drewballz1/Home-Assistant-Display-and-Satellite---Raspberry-Pi/README.md

# Raspberry Pi Touch Display 2 — Voice Satellite Stand

A desk stand for the **Raspberry Pi Touch Display 2 (7", landscape)** that houses a **Raspberry Pi 5**, a **Seeed ReSpeaker Lite** (2-mic array) and a **3" speaker** in a sealed box. It turns the display into an always-on Home Assistant panel (e.g. a doorbell camera feed) and a voice-assistant satellite (Linux Voice Assistant with a custom wake word).

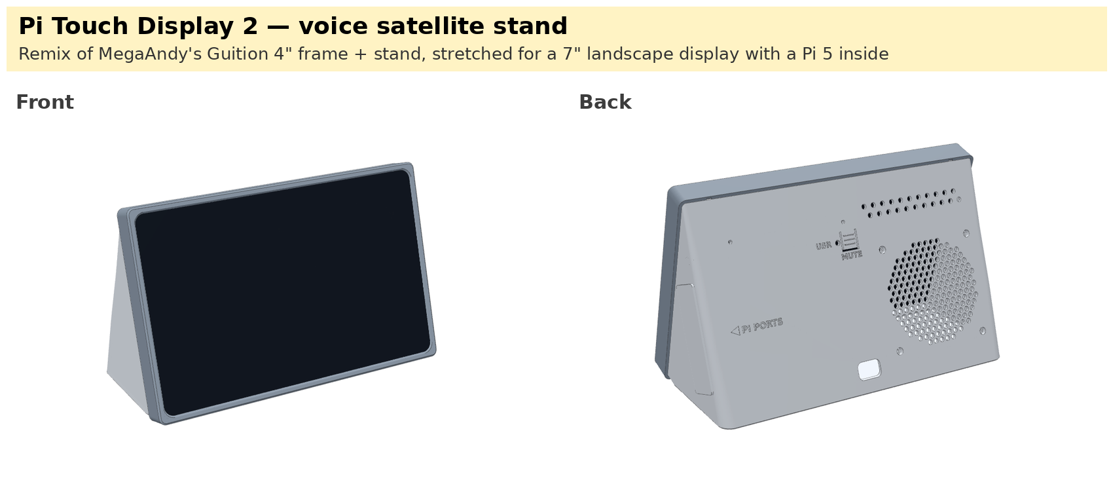
[picture p1: images/overview.png]
Overview


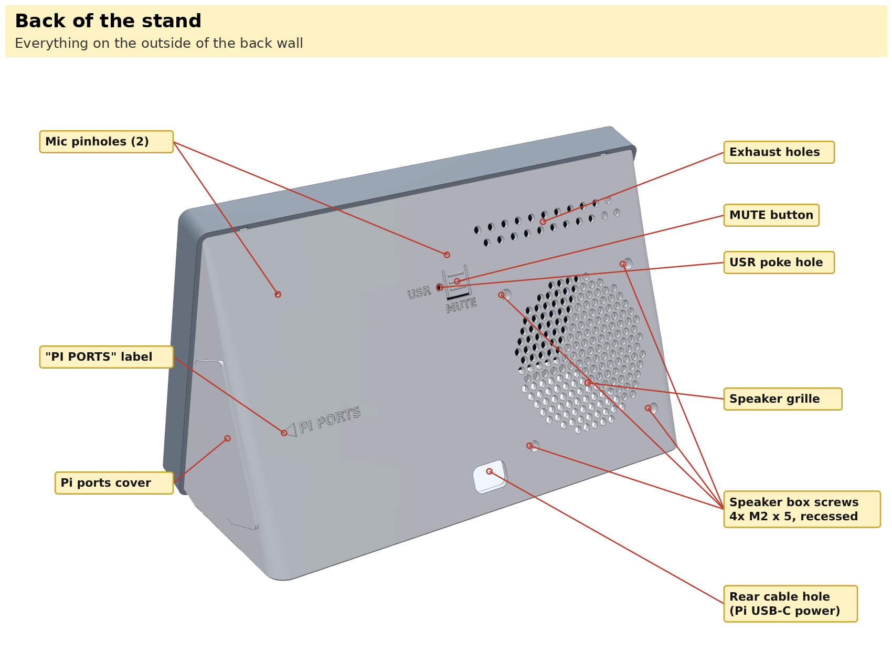
[picture p2: images/back-features.png]
Back of the stand


> **Remix notice.** This is a remix of **["Guition 4 inch Screen Frame and Stand (ESP32-S3-4848S040)" by MegaAndy](https://www.printables.com/model/1881011-guition-4-inch-screen-frame-and-stand-esp32-s3-4848s040)** on Printables. The frame band, wedge stand shape, snap tabs/grooves, rear cable hole, weighted base and foot recess all come from that design. The original STLs were stretched (not scaled) so every tested feature keeps its original size. This remix is shared under the same licence: **attribution required, non-commercial use only**.

## Print set (`stl/`)

| File | Print orientation | Notes |
|---|---|---|
| `stand.stl` | As exported: open front face down (same as the original) | ~190 × 123 mm footprint, 82 mm tall. Use a brim. No supports. |
| `frame.stl` | As exported: lip down | 194 × 125 × 16 mm. No supports. |
| `speaker-box.stl` | As exported: rim down | 80 × 80 × 60 mm. No supports (the inside must not have any). |
| `pi-ports-cover.stl` | As exported: plate down | 64 × 42 × 3.6 mm. No supports. |

Materials: **matte black ASA** for the stand, speaker box and cover; the frame in **Spectrum PET-G MATT Olive Green (RAL 6003)**, plain matte print (no fuzzy skin). 0.4 mm nozzle, 0.2 mm layers, 4 walls, 25 % infill, **no supports**. Bed of at least 200 × 130 mm (both plates below are laid out for 256 × 256). All parts were slice-checked (PrusaSlicer 2.7): no stability warnings, about 246 g in total.

**Sending it to a print shop (Bambu):** `print/` holds exactly what the printer gets and nothing else:
`TD2-plate-A-black-ASA-stand-box-cover.3mf` and `TD2-plate-B-olive-frame.3mf` (parts placed in print orientation), a plain-language note `TD2-note-for-Jayed.txt` and one picture `TD2-what-to-check.png`.

**Screw pilots and mic holes are printed undersize on purpose: drill them on site.** See [`docs/on-site-fixes.md`](docs/on-site-fixes.md) (1/16" and 3/32" bits). Design decisions and their reasons: [`docs/design-notes.md`](docs/design-notes.md).

## Hardware

| Part | Notes |
|---|---|
| Raspberry Pi Touch Display 2, 7" | 189.32 × 120.24 mm glass, 6.45 mm edge |
| Raspberry Pi 5 (2 GB is plenty) + Active Cooler (SC1148) | |
| 27 W USB-C power supply + USB-C cable with a **right-angle** Pi end | |
| Raspberry Pi 5 display cable, 22-way to 15-way, **300 mm** | the cable in the display box is meant for back-mounting the Pi |
| Seeed ReSpeaker Lite **USB** 2-Mic Array (no XIAO) | board revision v1.1 |
| Adafruit 3" speaker, 4 Ω 3 W | |
| JST-PH 2.0 mm 2-pin lead | speaker → ReSpeaker |
| Short USB-A → USB-C **data** cable, **right-angle on both ends** | Pi → ReSpeaker; the Pi's USB ports have 21 mm to the side cover |
| 1/16" and 3/32" drill bits, hobby knife | on-site fixes: pilots and mic holes are printed undersize |
| 10 × M2 × 5 pan-head self-tapping | the only screw in the build: 4 for the Pi, 2 for the ReSpeaker, 4 from the back into the speaker box (heads sit in recessed holes) |
| Foam tape: 2 mm (spacer ring), 1 mm (mic squares), 3 mm ring (speaker front), thin gasket (box rim) | |
| Optional: 1" × ½" steel flat bar, 3¾" long (~240 g) | glued into the weight tray on the floor |
| Optional: rubber feet, hot glue | |

## Features

- **Original look**: thin snap-on frame band and wedge stand, scaled up for a 7" landscape screen. Five snap tabs per long edge (three added, copied exactly from the original geometry).
- **Display clamp**: a spacer ring on the stand takes the 6.45 mm glass; 2 mm foam tape on the ring absorbs the ±0.5 mm tolerance. Frame corners match the glass's 8 mm radius.
- **Pi 5** on four printed standoffs on the back wall; USB-C power port sits right above the rear cable hole. Fit the microSD card before mounting.
- **Pi ports access**: clip-on cover on the right side (as you face the screen) over the USB / Ethernet end; lift it off with a fingernail at the notch under its lower front corner. See `images/pi-ports-cover.png`.
- **ReSpeaker Lite** on two M2 standoffs, mics sealed to two back-wall pinholes with small foam squares on raised pads.
- **MUTE** is a press-in flexure button printed into the back wall (with grip ridges); **USR** is a poke hole. Both engraved.
- **3" speaker** in its own sealed box (~160 cm³), clamped by four screws from the back; round-hole grille in the back wall.
- **Ventilation**: intake slots under the Pi, round exhaust holes along the top of the back wall.
- **Weight tray** on the floor for a steel bar (glued in), fitted before the display goes on.

## Assembly order

0. Do the on-site fixes (`docs/on-site-fixes.md`): drill the pilots and mic holes, clear the MUTE slot, test-fit the frame and cover.
1. Flash the microSD and insert it into the Pi.
2. Speaker: solder the JST lead (leave a little slack inside the box, tack it with hot glue), 3 mm foam ring on the wall around the grille, speaker face-down on its pads, gasket on the box rim, box over the speaker, four M2 × 5 screws from the back (into the recessed holes). Seal the wire hole with hot glue.
3. ReSpeaker: foam squares on the two mic pads, each with a clean **Ø2 mm hole** lined up with its pinhole (a 2 mm hollow punch, or a 5/64" bit twisted by hand; don't just pierce it, a pin-prick muffles the mic). The seal must be airtight all round. Board on its standoffs (mics to the wall), two M2 × 5 screws.
4. Pi: four M2 × 5 screws. Connect the ReSpeaker (USB), speaker (JST-PH), display ribbon (300 mm, fold the slack flat) and the display's GPIO power lead.
5. Weight bar into its tray (construction adhesive or hot glue).
6. 2 mm foam tape on the spacer ring, display on the ring, frame snapped on (feed cables first).
7. Side cover on; rubber feet on the base.

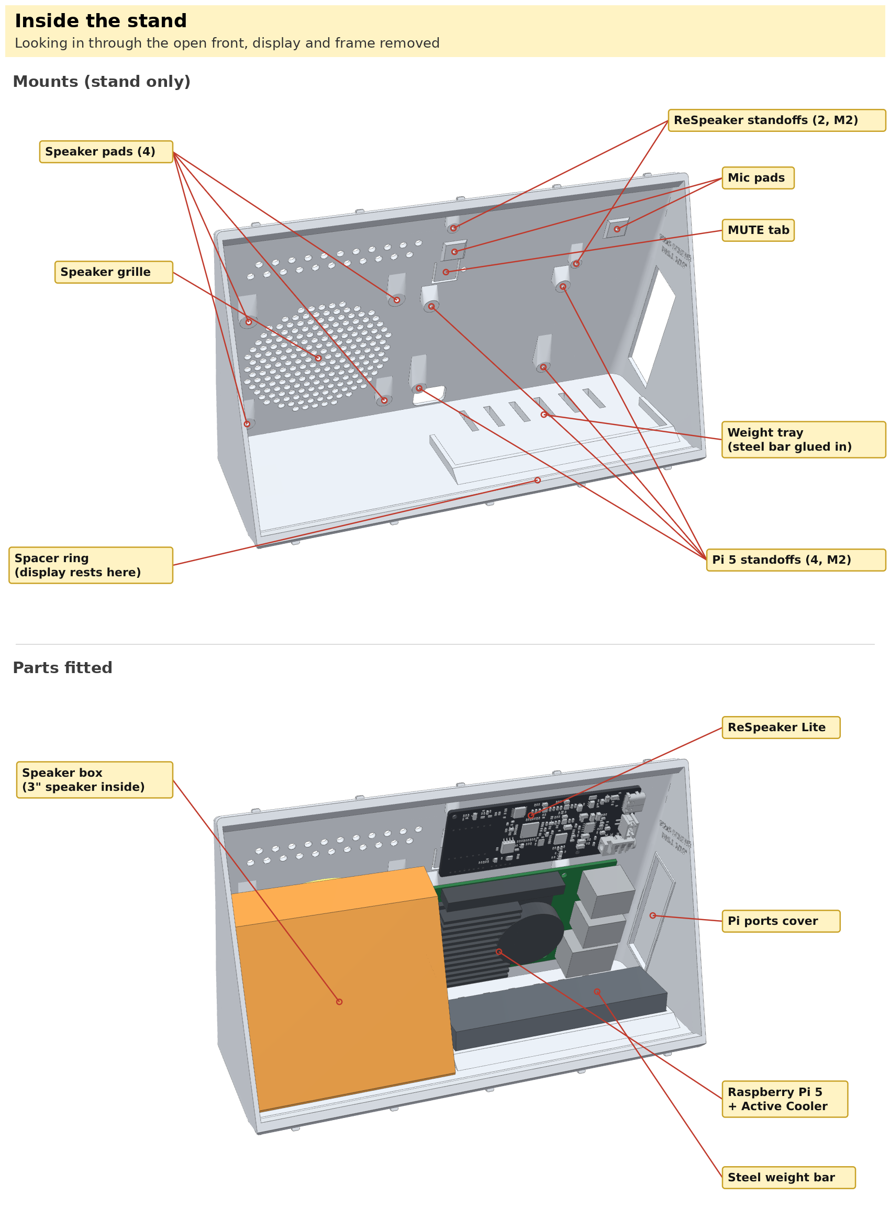
[picture p3: images/inside-mounts.png]
Inside the stand

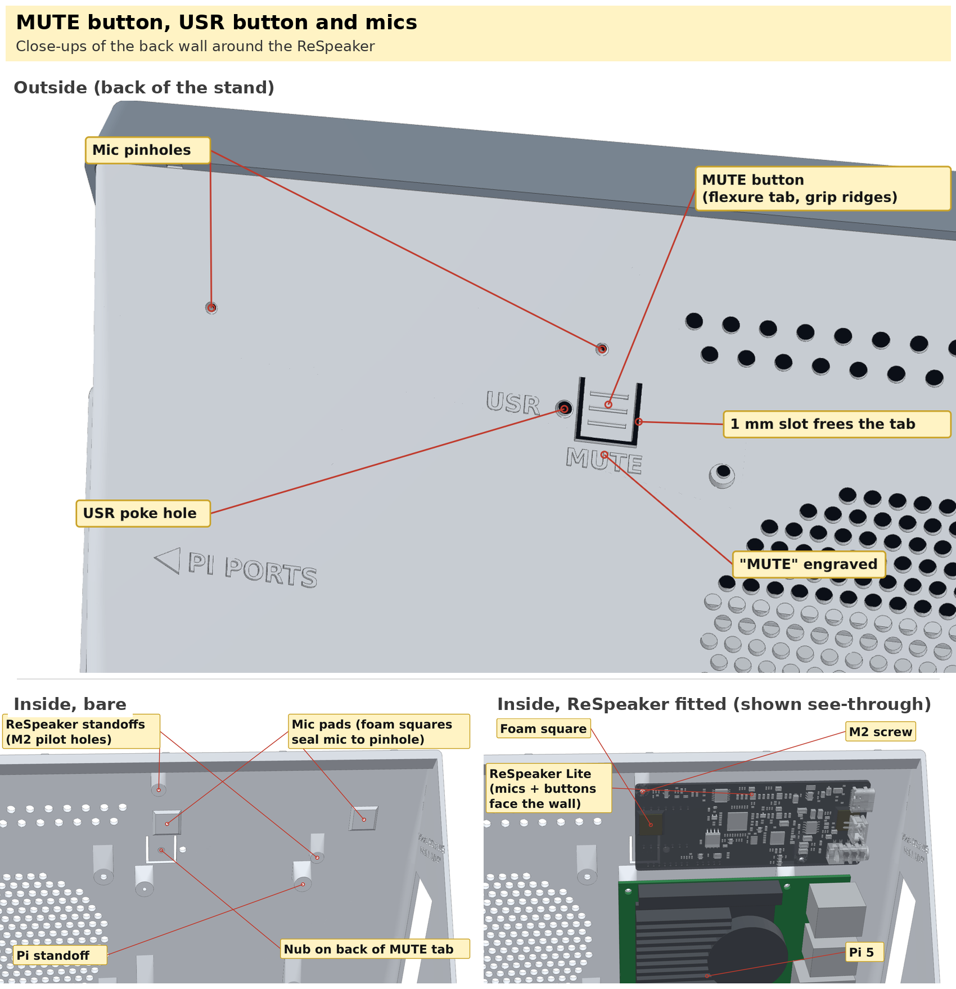
[picture p4: images/mute-button.png]
MUTE button, USR button and mics

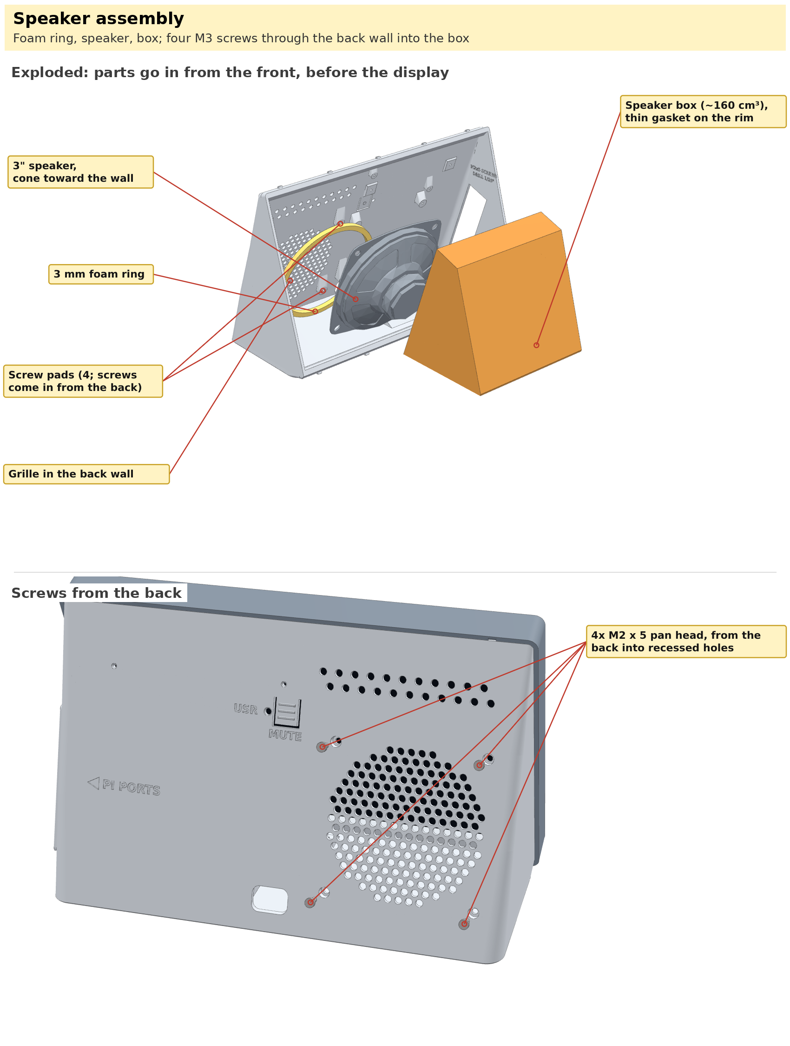
[picture p5: images/speaker-assembly.png]
Speaker assembly

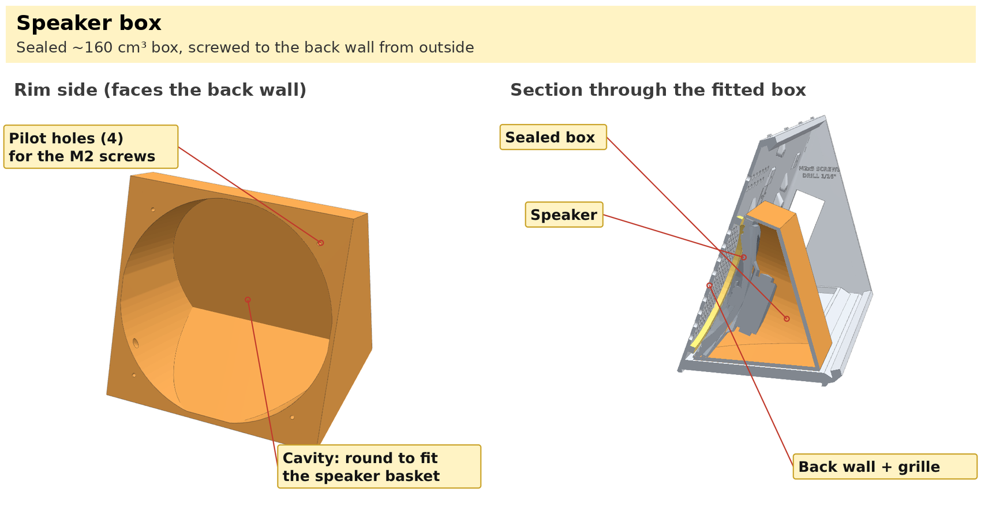
[picture p6: images/speaker-box-sections.png]
Speaker box

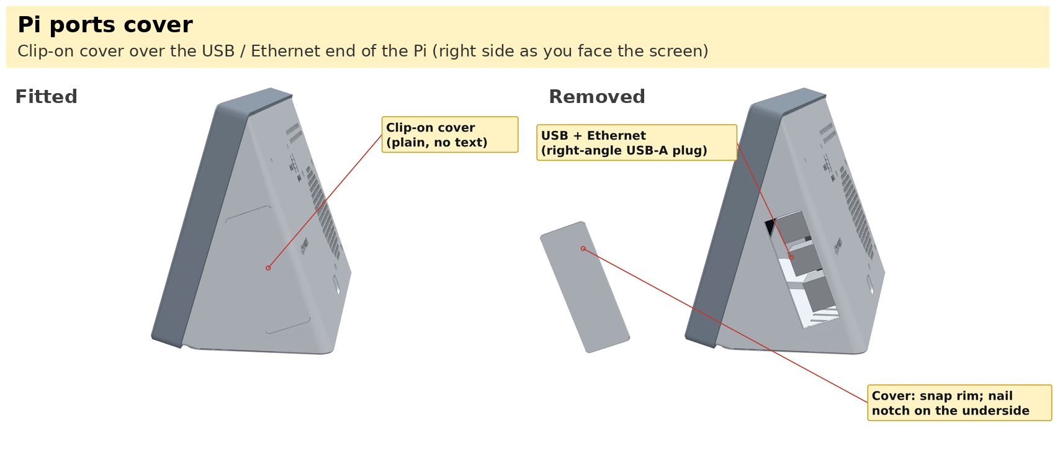
[picture p7: images/pi-ports-cover.png]
Pi ports cover


## Check before printing

These were designed from published CAD / drawings and need a quick check against the real parts:

1. **Speaker tabs**: geometry is from Adafruit's CAD for the 8 Ω 1 W 3" speaker (same frame size as the 4 Ω 3 W). Confirm the four corner slots line up with a 60 mm square.
2. **ReSpeaker**: confirm the board is v1.1 and that the button marked MUTE is the one nearer the left end (the end without connectors). If not, swap `btn_label` in `source/td2-stand-additions.scad`.
3. **Glass edge thickness**: if it measures 6.45 mm, 1 mm foam on the ring is enough; otherwise use 2 mm.

## Software (brief)

- Home Assistant dashboard / camera feed in a full-screen browser (kiosk).
- **Linux Voice Assistant** (Open Home Foundation) as the Assist satellite; custom microWakeWord / openWakeWord models load from its wake-word folder.
- The Pi 5 has no hardware H.264 decoder — use a 720p sub-stream for the camera feed.

## Source (`source/`)

OpenSCAD + Python (trimesh / manifold3d) build scripts. `stretch.py` performs the feature-preserving stretch of the original STLs (download them from the original Printables page — they are not redistributed here). `td2-stand-additions.scad` holds the added features and their parameters; `compose.py` assembles the stand; `spkbox2.py`, `door.py`, `frame_corners.py` build the other parts; `check.py` / `check2.py` run the clearance checks. `fix_planar.py` repairs triangles the stretch folds over on flat faces (run on the stretched base and on the composed stand); `folds.py` and `thin.py` check every part for fold-overs and sub-0.2 mm skins. `render/` holds the three.js renderer used for the images in `images/`.

Dimensions were taken from: the Raspberry Pi Touch Display 2 product brief, Seeed's ReSpeaker Lite v1.1 STEP model, and Adafruit's CAD parts library. Those source files are not included.

## Licence

**CC BY-NC 4.0** — see `LICENSE`. Credit: original design by **MegaAndy**, ["Guition 4 inch Screen Frame and Stand (ESP32-S3-4848S040)"](https://www.printables.com/model/1881011-guition-4-inch-screen-frame-and-stand-esp32-s3-4848s040) on Printables.
