drewballz1/Home-Assistant-Display-and-Satellite---Raspberry-Pi/print/TD2-plate-B-olive-frame.3mf

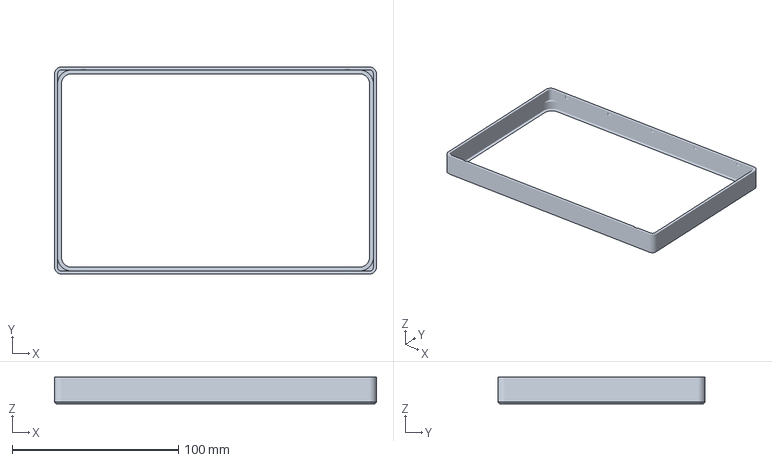
[picture p8: CAD file, 2026-11-02]
print/TD2-plate-B-olive-frame.3mf
193.6 x 124.5 x 16.0 mm
