drewballz1/Home-Assistant-Display-and-Satellite---Raspberry-Pi/stl/stand.stl

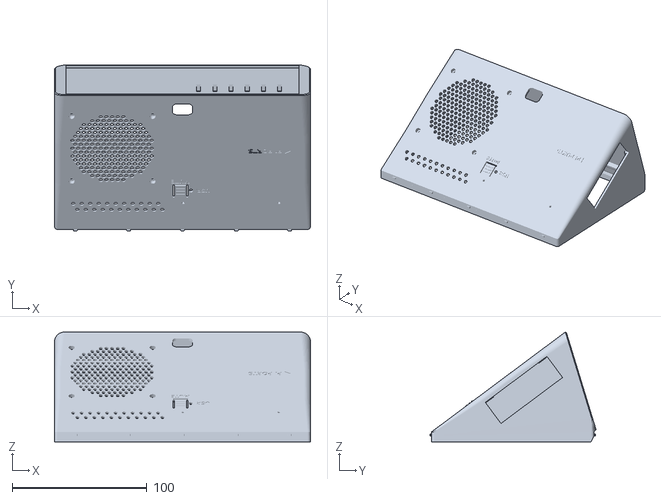
[picture p9: CAD file, 2026-11-02]
stl/stand.stl
189.7 x 123.1 x 81.5
