drewballz1/Home-Assistant-Display-and-Satellite---Raspberry-Pi/print/TD2-plate-A-black-ASA-stand-box-cover.3mf

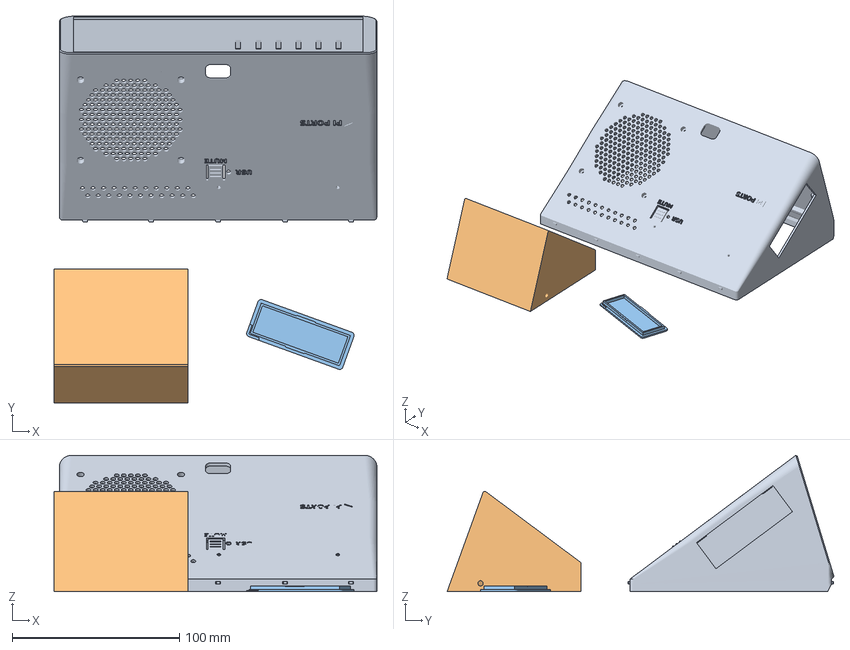
[picture p10: CAD file, 2026-11-02]
print/TD2-plate-A-black-ASA-stand-box-cover.3mf
192.9 x 231.0 x 81.5 mm
stand
speaker-box
pi-ports-cover
