drewballz1/Home-Assistant-Display-and-Satellite---Raspberry-Pi/stl/speaker-box.stl

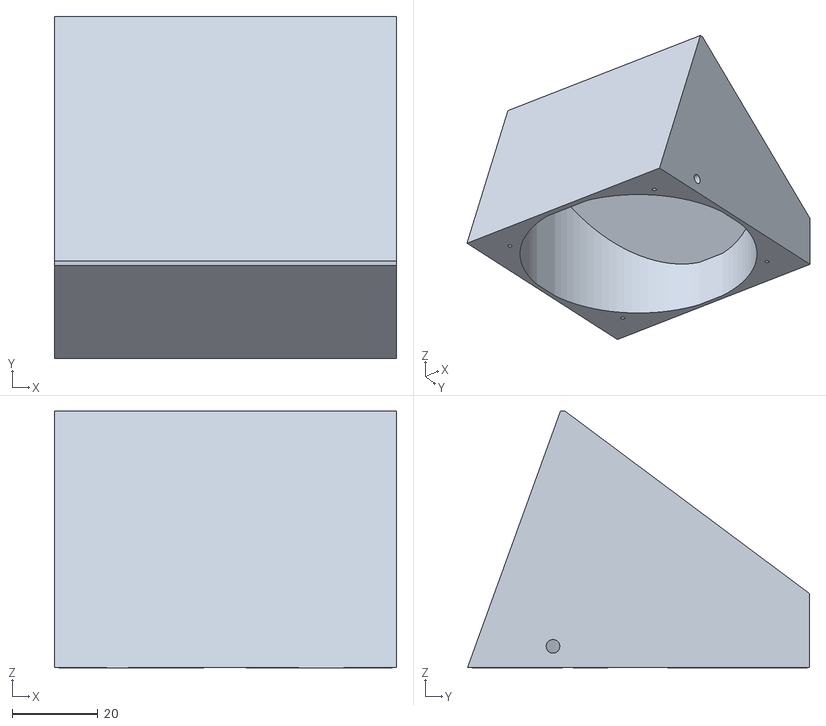
[picture p11: CAD file, 2026-11-02]
stl/speaker-box.stl
80.0 x 80.0 x 60.0
