drewballz1/Home-Assistant-Display-and-Satellite---Raspberry-Pi/stl/pi-ports-cover.stl

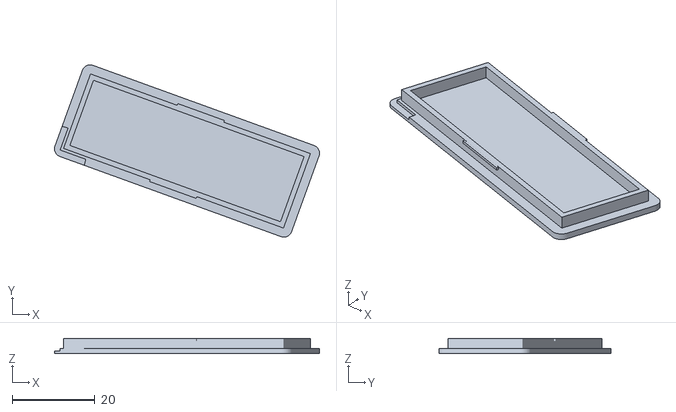
[picture p12: CAD file, 2026-10-27]
stl/pi-ports-cover.stl
64.2 x 41.7 x 3.56
