drewballz1/Home-Assistant-Display-and-Satellite---Raspberry-Pi/source/M.scad

M_USE = [[1.000000,0.000000,0.000000,0.000000],[0.000000,-0.289177,0.957276,45.650156],[0.000000,-0.957276,-0.289177,133.793919],[0.000000,0.000000,0.000000,1.000000]];
