drewballz1/Home-Assistant-Display-and-Satellite---Raspberry-Pi/(list of files, cad)

Other CAD files:
stl/frame.stl
