drewballz1/Home-Assistant-Display-and-Satellite---Raspberry-Pi/print/TD2-note-for-Jayed.txt

Hi Jayed, here are the Bambu Studio files for the TD2 display stand. 2 files, 4 parts, already placed on the plate the right way up. Please print them as-is.

FILE 1: TD2-plate-A-black-ASA-stand-box-cover.3mf
  1 x stand, 1 x speaker box, 1 x cover
  Material: matte black ASA, 0.20 mm layers (0.20mm Standard)

FILE 2: TD2-plate-B-olive-frame.3mf
  1 x frame
  Material: Spectrum PET-G MATT Olive Green (RAL 6003), or the closest matte olive you have (check with me first). 0.20 mm layers.

1. Open the .3mf. If it says "not from Bambu Lab, load geometry only", that's normal. Click OK.
   If it also says it repaired a few mesh errors, that's fine too (tiny flat slivers, no effect on the print).
2. Pick your printer, the material above, 0.20mm Standard.
3. Change only these (both files):
   - Strength > Walls > Wall loops = 4
   - Strength > Sparse infill > Sparse infill density = 25%
   - Support > Enable support = OFF (nothing on these parts needs support)
   File 1 only:
   - Others > Bed adhesion > Brim type = Outer brim only, Brim width = 5 mm
4. After slicing, the preview should show:
   - File 1: the stand sitting on its open side with the holes facing up. No support anywhere. A brim around the parts.
     The small U-shaped slot (MUTE button) and the 2 tiny mic holes should show as gaps.
     The text on top reads backwards from above. That's correct.
   - File 2: the frame lying flat, front face down. No fuzzy skin anywhere (plain print).
5. Don't rotate or re-orient anything.

I couldn't open these files in Bambu Studio myself, so please check the preview against the picture (TD2-what-to-check.png). If anything looks different, message me before printing.

Thanks!
