drewballz1/Home-Assistant-Display-and-Satellite---Raspberry-Pi/print/TD2-what-to-check.png

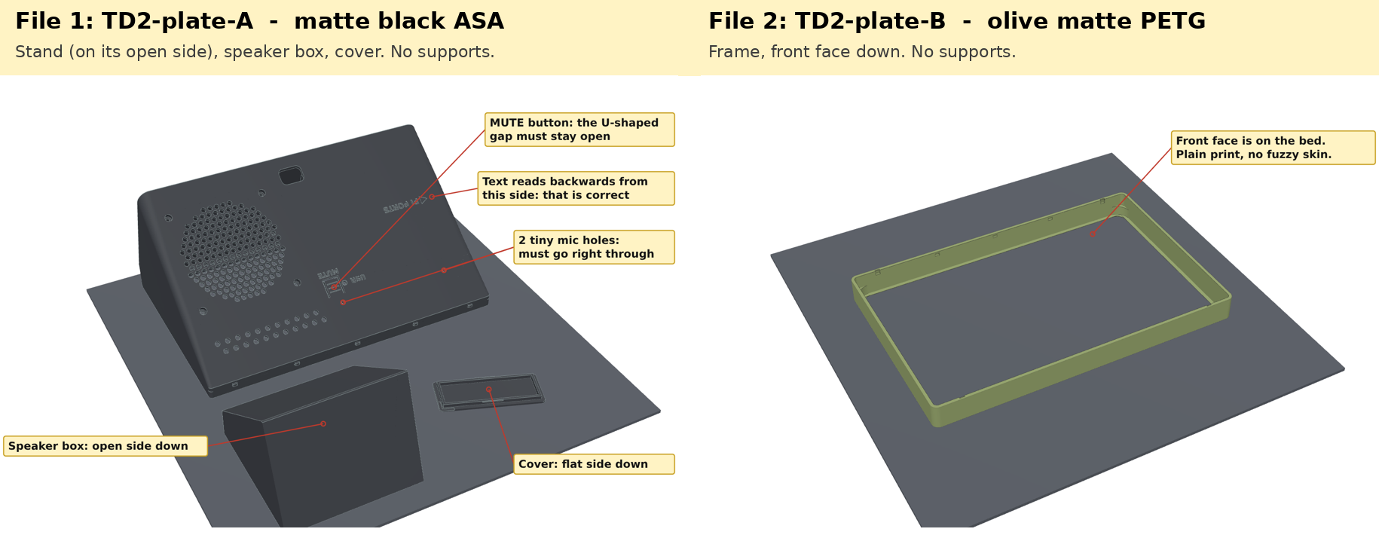
print/TD2-what-to-check.png
