drewballz1/Home-Assistant-Display-and-Satellite---Raspberry-Pi/(commit log)

2026-10-25 Initial release: Pi Touch Display 2 satellite stand
    Remix of "Guition 4 inch Screen Frame and Stand (ESP32-S3-4848S040)" by MegaAndy
    (https://www.printables.com/model/1881011), CC BY-NC 4.0.
    Claude-Session: https://claude.ai/code/session_013mbAUoxRrcFvJomUevHXCc
    [M.scad, frame.stl, pi-ports-cover.stl, speaker-box.stl, stand.stl, td2-stand-additions.scad]
2026-10-25 Re-render images from the current models
    Angled views with callouts, close-ups taken on the full stand, latest
    ReSpeaker standoff mount, real component models (ReSpeaker STEP,
    Adafruit speaker CAD), new back-features image.
    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
2026-10-27 Pi ports cover: move fingernail notch to the underside
    The notch was a step in the top face, which gives a nail nothing to get
    under. It is now a 0.6 mm relief on the underside of the plate overhang
    at the lower front corner, so the top face stays flat. Renders updated.
    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
    [pi-ports-cover.stl]
2026-10-27 Stand: repair stretch fold-overs and countersink skins
    - The stretch flipped some long thin triangles on the side walls inside out,
    which showed as a line above the Pi ports cover. Flat faces containing a fold
    are now re-triangulated from their exact boundary (fix_planar.py); the
    surface moves by at most 0.05 mm.
    - The speaker-screw countersinks started 0.01 mm inside the outer face,
    leaving a sub-micron skin and sliver triangles. They now start outside the wall.
    - All parts: zero fold-overs, watertight, single body. Clearance and overhang
    checks unchanged. Renders updated.
    Claude-Session: https://claude.ai/code/session_013mb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
    [stand.stl, td2-stand-additions.scad]
2026-10-31 One screw size throughout: 10 x M2 x 5 pan-head self-tapping
    - Pi standoff pilots 2.2 -> 1.6 mm (M2 in the Pi's 2.7 mm holes).
    - Speaker box screws now go into 4.4 mm recesses in the back wall pads, head
    seated 1.5 mm into the pad; 2.5 mm thread into the box. Box pilots 2.6 -> 1.6 mm.
    - ReSpeaker unchanged (its holes are 2.16 mm, which is why M2 is the common size).
    - Checks: watertight, no folds, clearances and overhangs unchanged. README + renders updated.
    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
    [speaker-box.stl, stand.stl, td2-stand-additions.scad]
2026-11-01 Print-shop package; weight tray and hole grille for clean face-down printing
    - Slicing the stand (PrusaSlicer 2.7) flagged a collapsing overhang and a thin
    fragile part. Causes: the covered weight pocket's top edge started in mid-air
    when printed face-down, and the long grille slots left thin leaning bars.
    - Weight pocket -> open tray on the floor (front lip ramped at 33 deg); same
    steel bar and position, glued in.
    - Speaker grille slots -> round holes (hex grid, ~40 % open), matching the vents.
    - All four parts now slice with no warnings and no supports (~246 g PETG, ~23 h).
    - print/: two-page print instructions PDF, PrusaSlicer 3MF projects with
    settings embedded, PETG profile. REA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
    [plate1-stand.3mf, plate2-frame.3mf, plate3-speaker-box-and-cover.3mf, stand.stl, td2-stand-additions.scad]
2026-11-01 Frame: fuzzy-skin texture on the outside band (print project + instructions)
    Outside walls only (0.25 mm / 0.7 mm): the glass pocket and snap grooves stay
    smooth (checked in the sliced G-code). +0.2 g, +2 min. No change to the STL.
    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
    [plate2-frame.3mf]
2026-11-01 Print instructions: frame colour Spectrum PET-G MATT Olive Green (RAL 6003)
    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
2026-11-01 Print instructions: keep to two pages
    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
2026-11-02 Print hand-off per the 3D print playbook
    - Pilot holes (Pi, ReSpeaker, speaker box) printed at 1.4 mm, drilled 1/16" on site.
    - 'M2x5 SCREWS / DRILL 1/16"' engraved inside the right side wall (prints
    vertically; on the back wall the letters would start in mid-air).
    - print/: two Bambu Studio 3MFs, one per material (A: black ASA stand + box +
    cover; B: olive frame with fuzzy skin painted on the outside band, 0.05/0.25),
    a plain-language note for the printer and one picture with arrows.
    Old PrusaSlicer projects and PDF removed.
    - docs/: on-site fixes and design notes.
    - Re-checked: watertight, single bodies, no folds, clearances unchanged,
    PrusaSlicer slice clean, 3MF volumes match t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
    [TD2-plate-A-black-ASA-stand-box-cover.3mf, TD2-plate-B-olive-frame.3mf, plate1-stand.3mf, plate2-frame.3mf, plate3-speaker-box-and-cover.3mf, speaker-box.stl, stand.stl, td2-stand-additions.scad]
2026-11-02 Frame: drop fuzzy skin (plain matte print)
    Fuzzy skin would need trial prints to tune, and the printer doesn't do test
    pieces. Plate B 3MF has no paint; note, picture, README, design notes updated.
    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
    [TD2-plate-A-black-ASA-stand-box-cover.3mf, TD2-plate-B-olive-frame.3mf]
2026-11-02 Renders: ignore sliver triangles when drawing edges
    The line from the speaker grille to the lower speaker screw hole (and one
    across the top right) were long, paper-thin sliver triangles left by the
    boolean cuts. They lie flat in the surface (no gap, step or thickness) and
    don't change the print (the original STL has 176 of them), but their
    numerically meaningless normals made the renderer draw false edges.
    Edges are now precomputed (source/render/edges.py) skipping slivers.
    All images and the printer's picture re-rendered. Models unchanged.
    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
2026-11-02 Printer note: mention Bambu's harmless mesh-repair message
    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
2026-11-02 Assembly: cut a 2 mm hole in the mic foam instead of piercing it
    A pin-prick through the foam becomes the bottleneck and muffles the mic.
    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
2026-11-06 source/: add the remaining build and check scripts
    stretch, touse, frame_corners, door, fix_planar, folds, thin, islands and the
    clearance checks, so the design can be rebuilt (e.g. for a 10.1" version).
    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
